onionsat-pcbs/neptune-env/bom.xlsx

Reference | Qty | Name/value | Footprint
C1 | 1 | 100nF | Capacitor_SMD:C_0603_1608Metric
C2,C4,C16,C17,C18,C19,C20,C21 | 8 | 100nF | Capacitor_SMD:C_0402_1005Metric
C5,C6,C8,C9,C11,C12 | 6 | 100nF | Capacitor_SMD:C_0201_0603Metric
C7,C10,C13 | 3 | 10nF | Capacitor_SMD:C_0402_1005Metric
C14,C15 | 2 | 1uF | Capacitor_SMD:C_0603_1608Metric
C22 | 1 | 4.7uF | Capacitor_SMD:C_0603_1608Metric
J1 | 1 | 8 pin, 2mm ptich, SMD, right angle socket | -
J2 | 1 | Neptune 2x10 connector, 1 female, 1 male | -
J3 | 1 | Neptune 2x10 connector, 1 female, 1 male | -
R1 | 1 | 10k | Resistor_SMD:R_0402_1005Metric
R2,R3,R4 | 3 | 4k Ohm 0.1% | Resistor_SMD:R_1206_3216Metric
SW1 | 1 | reset | -
TH1,TH2,TH3 | 3 | PT1000 | -
U1 | 1 | STM32L432KCUx | -
U2,U3,U4 | 3 | MAX31865xTP | -
U5 | 1 | AP2112K-3.3 | -
U6,U7,U8 | 3 | BME690 | -
