onionsat-pcbs/neptune-env/neptune-env/3d/BME690.stp

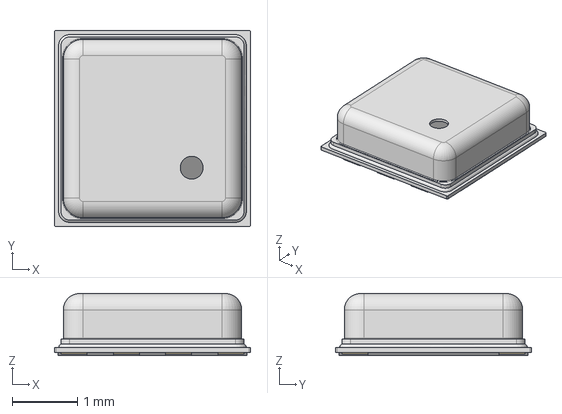
[picture p1: CAD file, 2025-12-16]
neptune-env/3d/BME690.stp
3.00 x 3.00 x 0.95 mm
