onionsat-pcbs/neptune-env/neptune-env/3d/ICM-20948.step

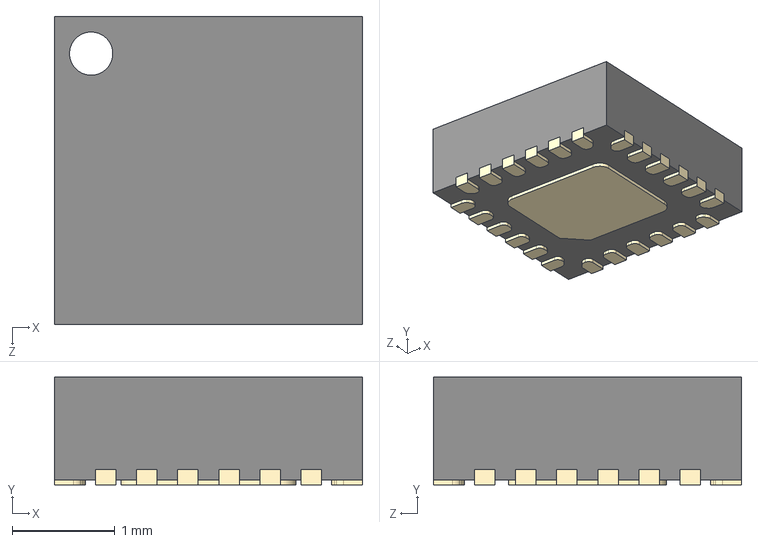
[picture p2: CAD file, 2025-12-16]
neptune-env/3d/ICM-20948.step
3.00 x 1.05 x 3.00 mm
