onionsat-pcbs/neptune-env/neptune-env/3d/KEY-SMD_L4.0-W3.0-LS4.9.step

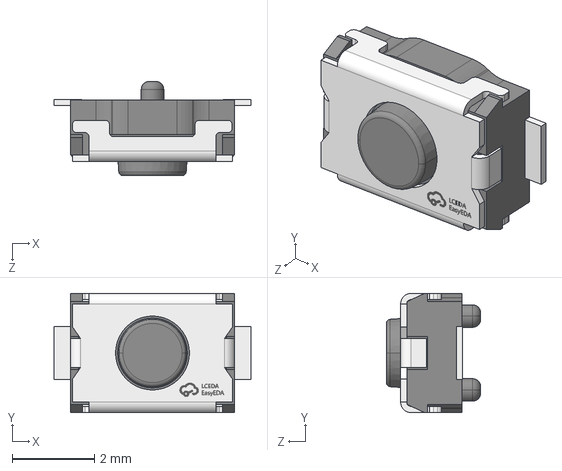
[picture p3: CAD file, 2025-12-11]
neptune-env/3d/KEY-SMD_L4.0-W3.0-LS4.9.step
4.80 x 2.90 x 2.30 mm
