onionsat-pcbs/neptune-env/neptune-env/3d/HDR2.00-F-LS-2X10P.step

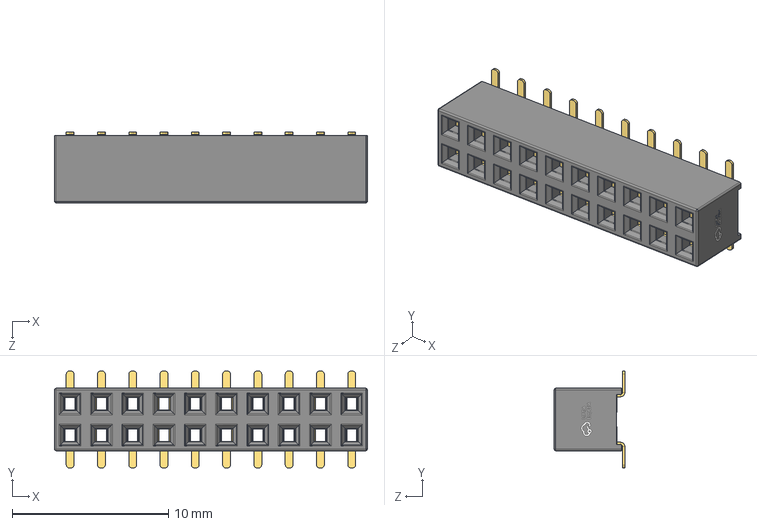
[picture p4: CAD file, 2025-12-11]
neptune-env/3d/HDR2.00-F-LS-2X10P.step
20.0 x 6.20 x 4.52 mm
