onionsat-pcbs/neptune-env/neptune-env/3d/HDR-SMD_8P-P2.00-H-F-W9.2.step

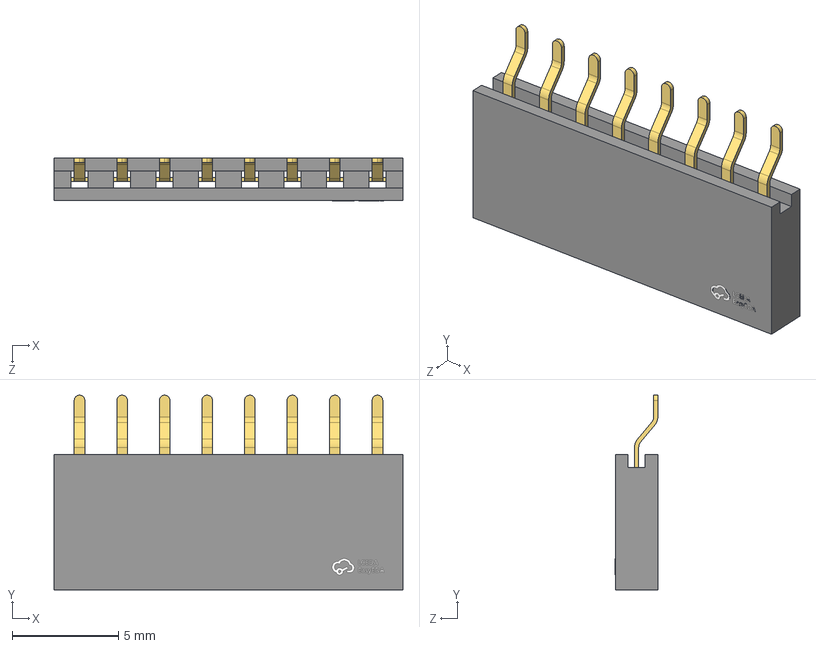
[picture p5: CAD file, 2025-12-09]
neptune-env/3d/HDR-SMD_8P-P2.00-H-F-W9.2.step
16.4 x 9.15 x 2.01 mm
