onionsat-pcbs/neptune-env/neptune-env/3d/max31865.step

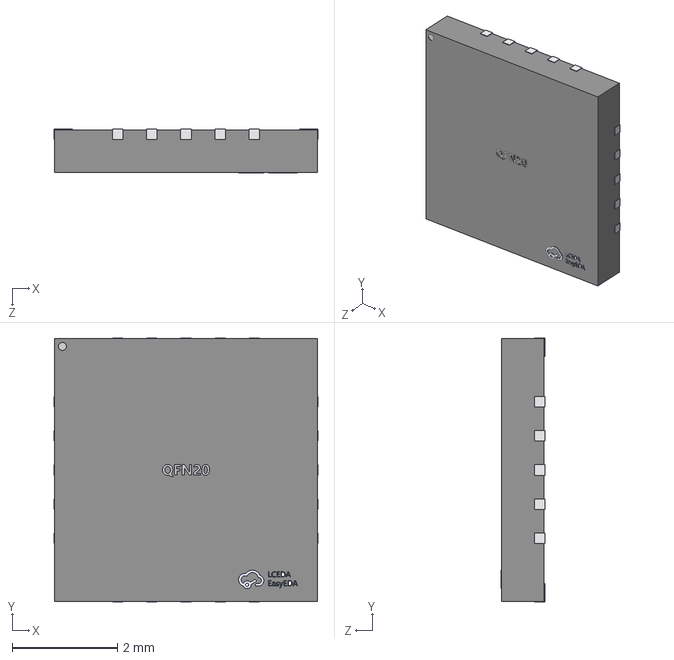
[picture p6: CAD file, 2025-12-11]
neptune-env/3d/max31865.step
5.02 x 5.02 x 0.83 mm
