onionsat-pcbs/neptune-env/neptune-env/neptune-env.kicad_pcb

## KiCad design neptune-env/neptune-env.kicad_pcb (2026-01-26)

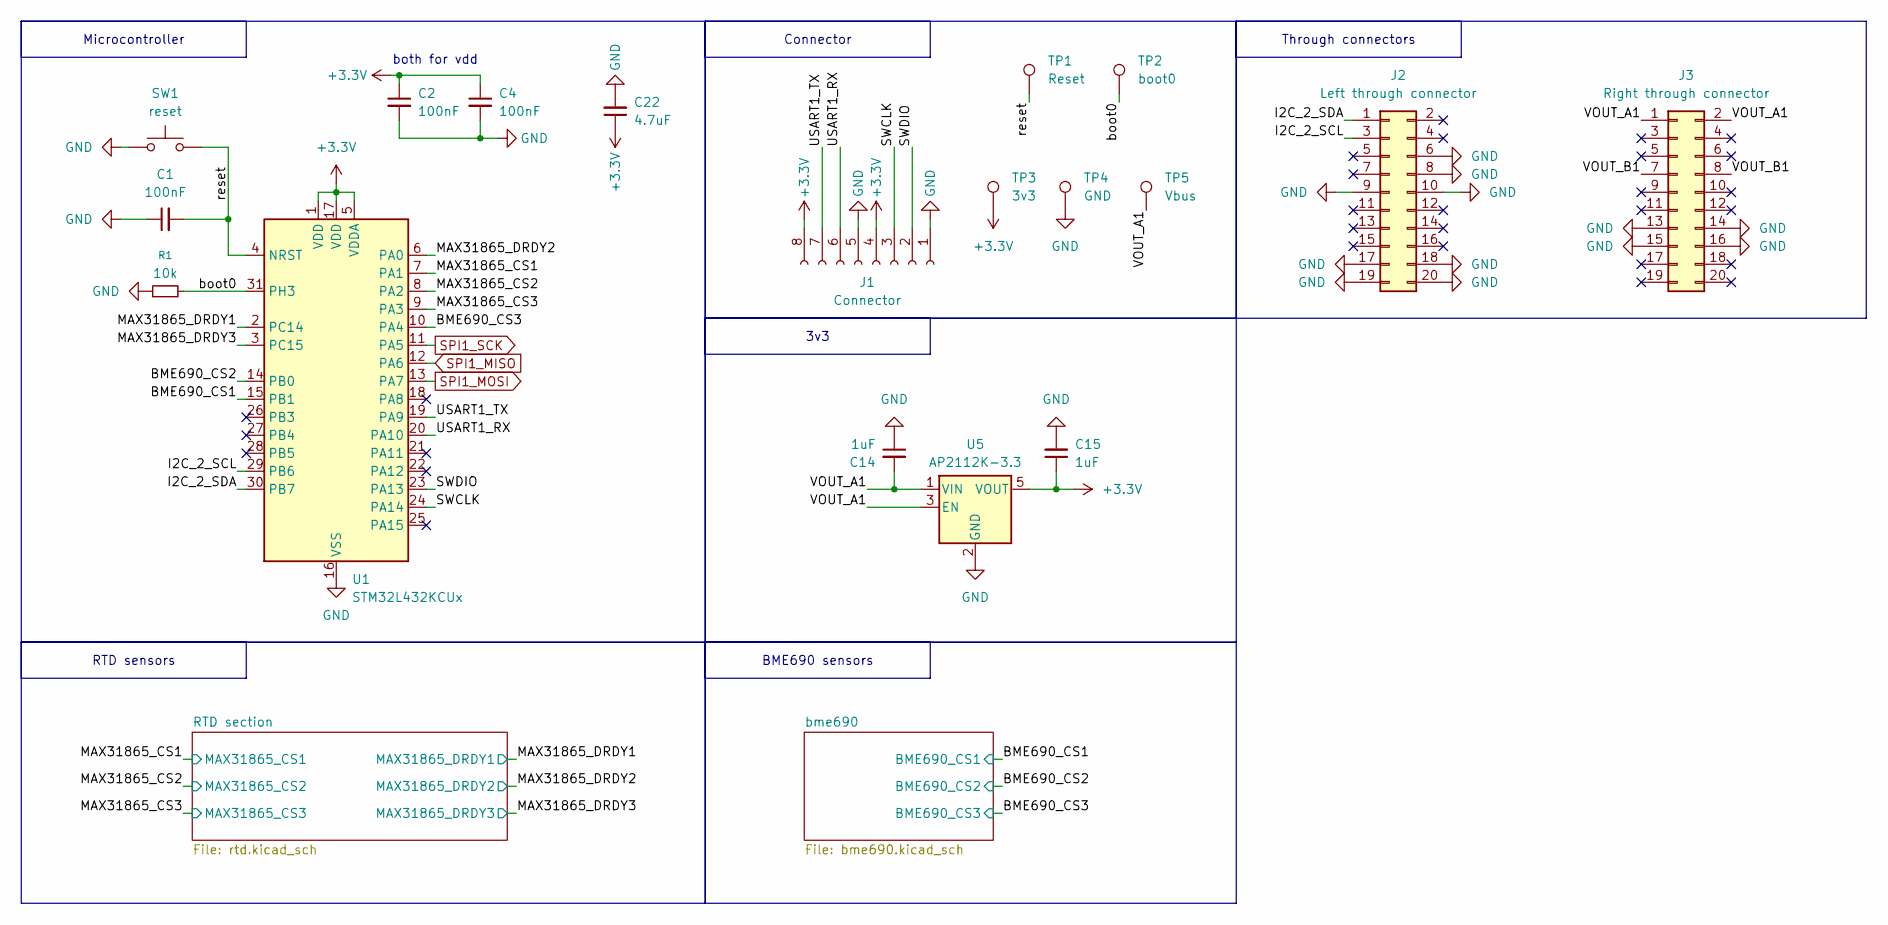
[picture p7: schematic neptune-env.kicad_sch, ENV PCB]

Parts:
C1: 100nF; C_0603_1608Metric
C2, C4: 100nF; C_0402_1005Metric
C14, C15: 1uF; C_0603_1608Metric
C22: 4.7uF; C_0603_1608Metric
J1: Connector; HDR-SMD_8P-P2.00-H-F-W9.2
J2: Left through connector; gaia_connector
J3: Right through connector; gaia_connector
R1: 10k; R_0402_1005Metric
SW1: reset; KEY-SMD_L4.0-W3.0-LS4.9-1
TP1: Reset; TestPoint_Pad_1.0x1.0mm
TP2: boot0; TestPoint_Pad_1.0x1.0mm
TP3: 3v3; TestPoint_Pad_1.5x1.5mm
TP4: GND; TestPoint_Pad_1.5x1.5mm
TP5: Vbus; TestPoint_Pad_1.5x1.5mm
U1: STM32L432KCUx
U5: AP2112K-3.3; ap2112

Connections:
+3.3V: C2.1, C4.1, C15.1, C22.1, J1.4, J1.8, TP3.1, U1.1 (VDD), U1.5 (VDDA), U1.17 (VDD), U5.5 (VOUT); also elsewhere on the board
/BME690_CS1: U1.15 (PB1); also elsewhere on the board
/BME690_CS2: U1.14 (PB0); also elsewhere on the board
/BME690_CS3: U1.10 (PA4); also elsewhere on the board
/I2C_2_SCL: J2.3, U1.29 (PB6)
/I2C_2_SDA: J2.1, U1.30 (PB7)
/MAX31865_CS1: U1.7 (PA1); also elsewhere on the board
/MAX31865_CS2: U1.8 (PA2); also elsewhere on the board
/MAX31865_CS3: U1.9 (PA3); also elsewhere on the board
/MAX31865_DRDY1: U1.2 (PC14); also elsewhere on the board
/MAX31865_DRDY2: U1.6 (PA0); also elsewhere on the board
/MAX31865_DRDY3: U1.3 (PC15); also elsewhere on the board
/SWCLK: J1.3, U1.24 (PA14)
/SWDIO: J1.2, U1.23 (PA13)
/USART1_RX: J1.6, U1.20 (PA10)
/USART1_TX: J1.7, U1.19 (PA9)
/VOUT_A1: C14.2, J3.1, J3.2, TP5.1, U5.1 (VIN), U5.3 (EN)
/VOUT_B1: J3.7, J3.8
/boot0: R1.2, TP2.1, U1.31 (PH3)
/reset: C1.2, SW1.2, TP1.1, U1.4 (NRST)
GND: C1.1, C2.2, C4.2, C14.1, C15.2, C22.2, J1.1, J1.5, J2.6, J2.8, J2.9, J2.10, J2.17, J2.18, J2.19, J2.20, J3.13, J3.14, J3.15, J3.16, R1.1, SW1.1, TP4.1, U1.16 (VSS), U1.32 (VSS), U1.33 (VSS), U5.2 (GND); also elsewhere on the board
SPI1_MISO: U1.12 (PA6); also elsewhere on the board
SPI1_MOSI: U1.13 (PA7); also elsewhere on the board
SPI1_SCK: U1.11 (PA5); also elsewhere on the board

Notes on the sheet:
both for vdd
Connector
Through connectors
Microcontroller
BME690 sensors
RTD sensors
3v3

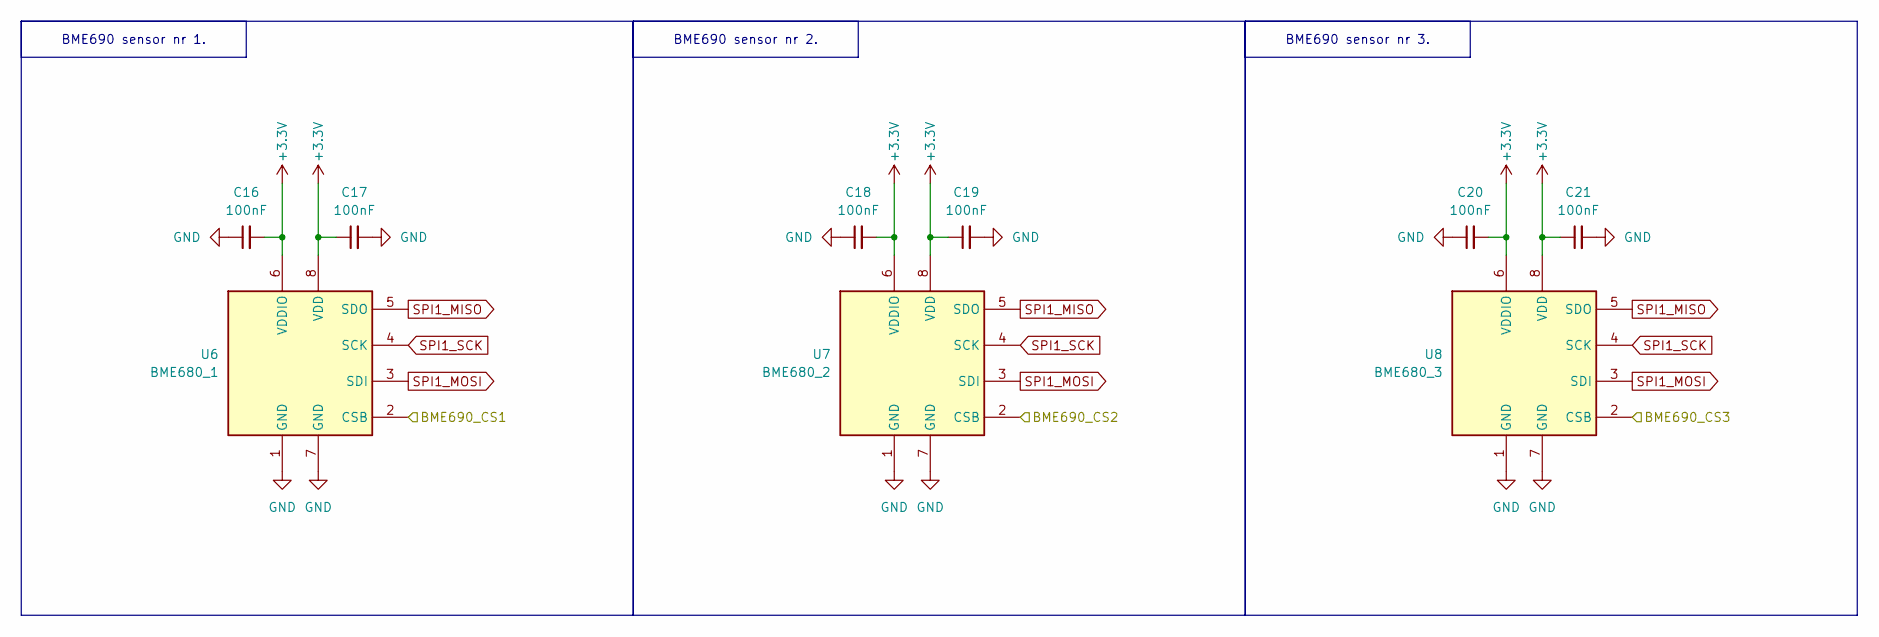
[picture p8: schematic bme690.kicad_sch, 3 BME690]

Parts:
C16, C17, C18, C19, C20, C21: 100nF; C_0402_1005Metric
U6: BME680_1; Bosch_LGA-8_3x3mm_P0.8mm_ClockwisePinNumbering
U7: BME680_2; Bosch_LGA-8_3x3mm_P0.8mm_ClockwisePinNumbering
U8: BME680_3; Bosch_LGA-8_3x3mm_P0.8mm_ClockwisePinNumbering

Connections:
+3.3V: C16.2, C17.1, C18.2, C19.1, C20.2, C21.1, U6.6 (VDDIO), U6.8 (VDD), U7.6 (VDDIO), U7.8 (VDD), U8.6 (VDDIO), U8.8 (VDD); also elsewhere on the board
/BME690_CS1: U6.2 (CSB); also elsewhere on the board
/BME690_CS2: U7.2 (CSB); also elsewhere on the board
/BME690_CS3: U8.2 (CSB); also elsewhere on the board
GND: C16.1, C17.2, C18.1, C19.2, C20.1, C21.2, U6.1 (GND), U6.7 (GND), U7.1 (GND), U7.7 (GND), U8.1 (GND), U8.7 (GND); also elsewhere on the board
SPI1_MISO: U6.5 (SDO), U7.5 (SDO), U8.5 (SDO); also elsewhere on the board
SPI1_MOSI: U6.3 (SDI), U7.3 (SDI), U8.3 (SDI); also elsewhere on the board
SPI1_SCK: U6.4 (SCK), U7.4 (SCK), U8.4 (SCK); also elsewhere on the board

Notes on the sheet:
BME690 sensor nr 3.
BME690 sensor nr 1.
BME690 sensor nr 2.

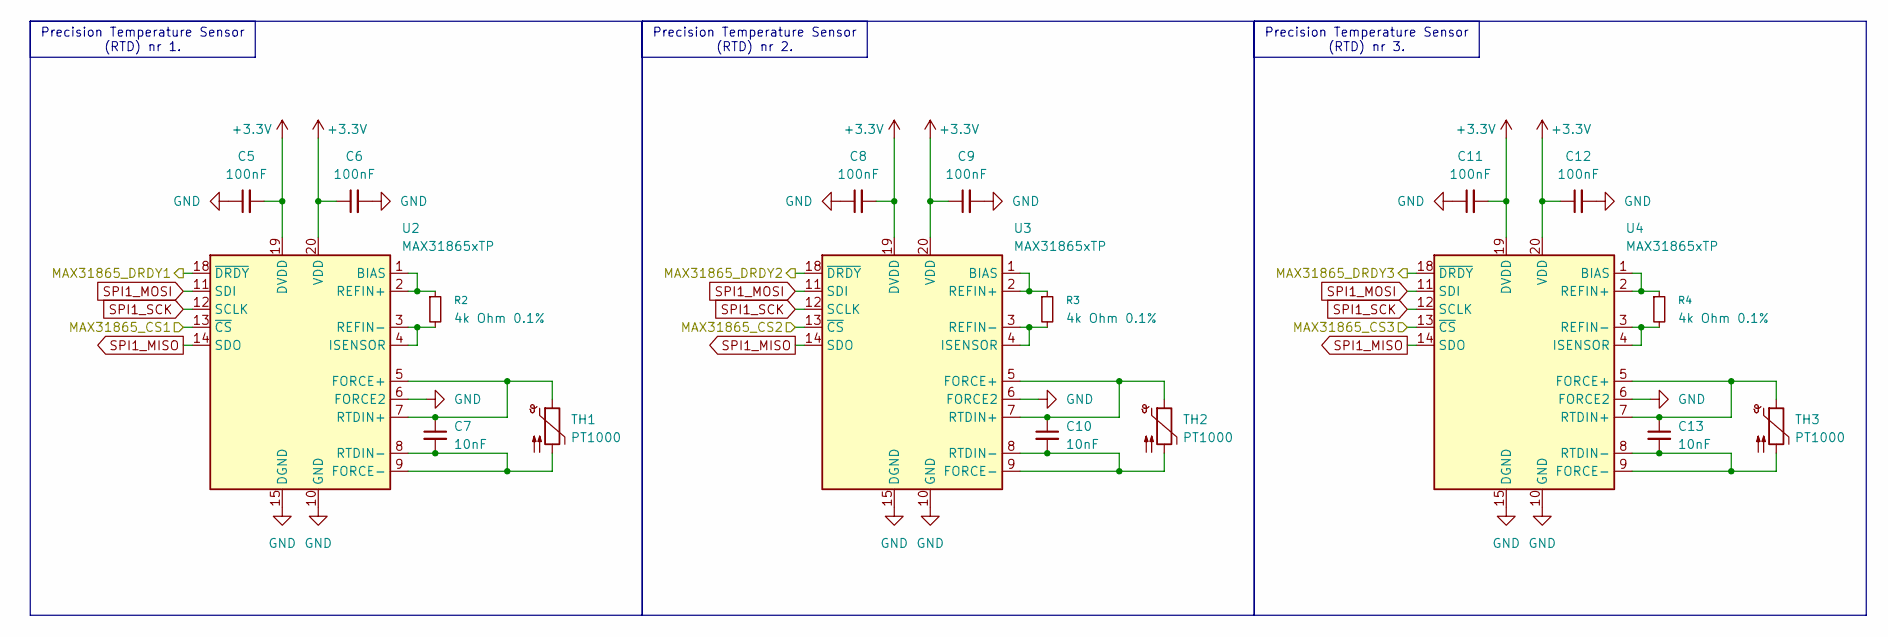
[picture p9: schematic rtd.kicad_sch, 3 RTD sensor]

Parts:
C5, C6, C8, C9, C11, C12: 100nF; C_0201_0603Metric
C7, C10, C13: 10nF; C_0402_1005Metric
R2, R3, R4: 4k Ohm 0.1%; R_1206_3216Metric
TH1, TH2, TH3: PT1000; yageo_m1020
U2, U3, U4: MAX31865xTP; MAX31865

Connections:
+3.3V: C5.2, C6.1, C8.2, C9.1, C11.2, C12.1, U2.19 (DVDD), U2.20 (VDD), U3.19 (DVDD), U3.20 (VDD), U4.19 (DVDD), U4.20 (VDD); also elsewhere on the board
/MAX31865_CS1: U2.13 (~CS); also elsewhere on the board
/MAX31865_CS2: U3.13 (~CS); also elsewhere on the board
/MAX31865_CS3: U4.13 (~CS); also elsewhere on the board
/MAX31865_DRDY1: U2.18 (~DRDY); also elsewhere on the board
/MAX31865_DRDY2: U3.18 (~DRDY); also elsewhere on the board
/MAX31865_DRDY3: U4.18 (~DRDY); also elsewhere on the board
GND: C5.1, C6.2, C8.1, C9.2, C11.1, C12.2, U2.6 (FORCE2), U2.10 (GND), U2.15 (DGND), U2.16 (GND), U2.21 (GND), U3.6 (FORCE2), U3.10 (GND), U3.15 (DGND), U3.16 (GND), U3.21 (GND), U4.6 (FORCE2), U4.10 (GND), U4.15 (DGND), U4.16 (GND), U4.21 (GND); also elsewhere on the board
unnamed: R2.1, U2.1 (BIAS), U2.2 (REFIN+)
unnamed: C7.1, TH1.1, U2.5 (FORCE+), U2.7 (RTDIN+)
unnamed: C7.2, TH1.2, U2.8 (RTDIN-), U2.9 (FORCE-)
unnamed: R2.2, U2.3 (REFIN-), U2.4 (ISENSOR)
unnamed: R3.1, U3.1 (BIAS), U3.2 (REFIN+)
unnamed: C10.1, TH2.1, U3.5 (FORCE+), U3.7 (RTDIN+)
unnamed: C10.2, TH2.2, U3.8 (RTDIN-), U3.9 (FORCE-)
unnamed: R3.2, U3.3 (REFIN-), U3.4 (ISENSOR)
unnamed: R4.1, U4.1 (BIAS), U4.2 (REFIN+)
unnamed: C13.1, TH3.1, U4.5 (FORCE+), U4.7 (RTDIN+)
unnamed: C13.2, TH3.2, U4.8 (RTDIN-), U4.9 (FORCE-)
unnamed: R4.2, U4.3 (REFIN-), U4.4 (ISENSOR)
SPI1_MISO: U2.14 (SDO), U3.14 (SDO), U4.14 (SDO); also elsewhere on the board
SPI1_MOSI: U2.11 (SDI), U3.11 (SDI), U4.11 (SDI); also elsewhere on the board
SPI1_SCK: U2.12 (SCLK), U3.12 (SCLK), U4.12 (SCLK); also elsewhere on the board

Notes on the sheet:
Precision Temperature Sensor (RTD) nr 3.
Precision Temperature Sensor (RTD) nr 2.
Precision Temperature Sensor (RTD) nr 1.

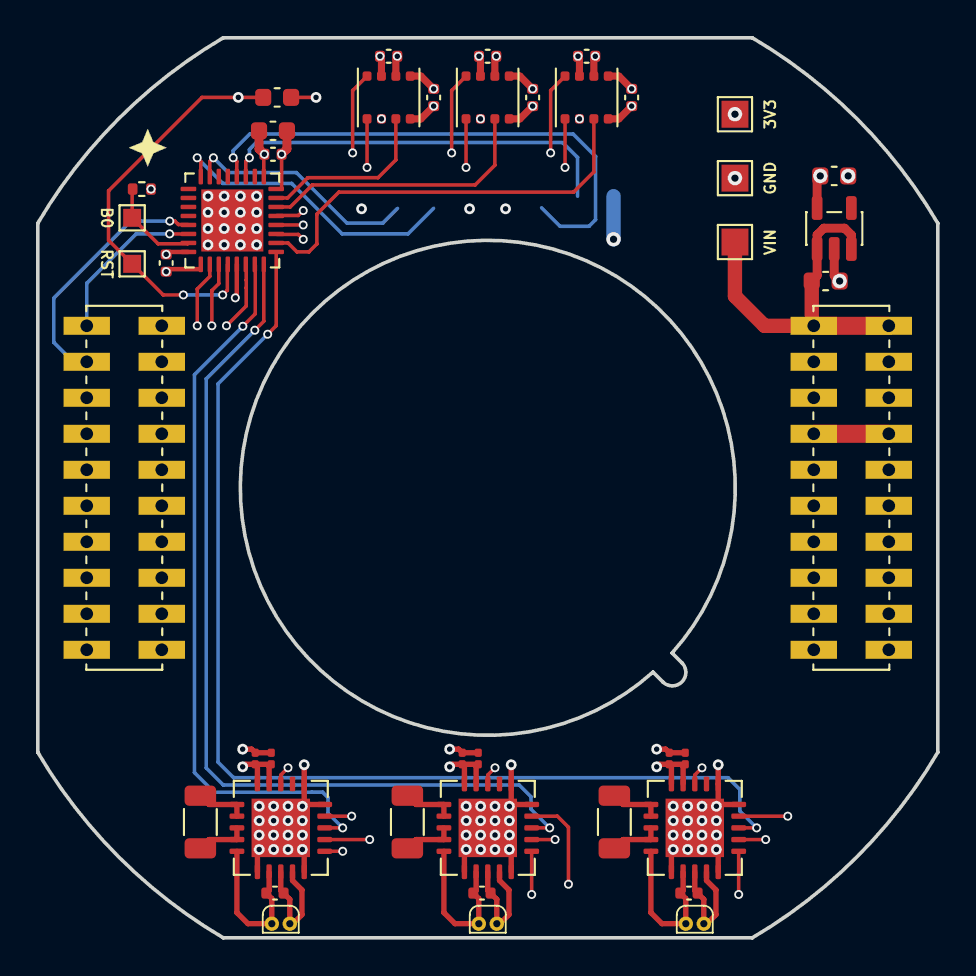
[picture p10: board neptune-env.kicad_pcb from above]

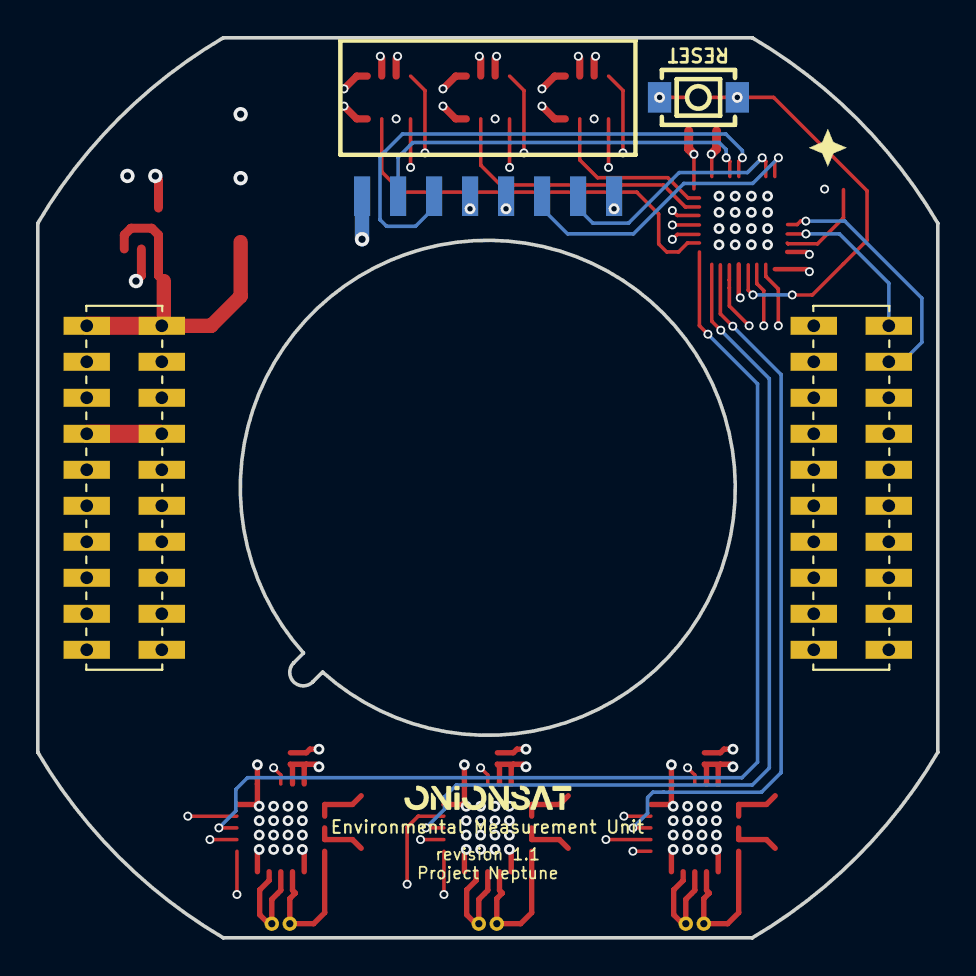
[picture p11: board neptune-env.kicad_pcb from below]

Board: 6 copper layers, 50.0 x 50.0 mm, 45 parts (2 on the bottom side), 36 nets.
