onionsat-pcbs/neptune-env/(commit log)

2025-12-08 initial relase
    [neptune-imu.kicad_pcb, neptune-imu.kicad_sch]
2025-12-09 no summary
    [HDR-SMD_8P-P2.00-H-F-W9.2.step, bme690.kicad_sch, neptune-imu.kicad_pcb, neptune-imu.kicad_sch, rtd.kicad_sch]
2025-12-11 almost ready
    [HDR2.00-F-LS-2X10P.step, KEY-SMD_L4.0-W3.0-LS4.9.step, LGA-8_L3.0-W3.0-P0.80-TR-1.step, max31865.step, neptune-imu.kicad_pcb, neptune-imu.kicad_sch, rtd.kicad_sch]
2025-12-11 project naming updated
    [HDR-SMD_8P-P2.00-H-F-W9.2.step, HDR2.00-F-LS-2X10P.step, KEY-SMD_L4.0-W3.0-LS4.9.step, LGA-8_L3.0-W3.0-P0.80-TR-1.step, bme690.kicad_sch, max31865.step, neptune-env.kicad_pcb, neptune-env.kicad_sch]
2025-12-11 some advancements
    [neptune-env.kicad_pcb]
2025-12-16 some final things to do
    [BME690.stp, HDR2.00-F-LS-2X10P.step, ICM-20948.step, LGA-8_L3.0-W3.0-P0.80-TR-1.step, bom.xlsx, neptune-env.kicad_pcb, neptune-env.kicad_sch]
2025-12-16 ready
    final check needed
    [neptune-env.kicad_pcb]
2025-12-17 working on my PC
    [neptune-env.kicad_pcb]
2025-12-18 Review: OK for production
    [neptune-env.kicad_pcb]
2025-12-21 fixing bugs, production
    [neptune-env-3V3.gbr, neptune-env-B_Cu.gbr, neptune-env-B_Mask.gbr, neptune-env-B_Paste.gbr, neptune-env-B_Silkscreen.gbr, neptune-env-Edge_Cuts.gbr, neptune-env-F_Cu.gbr, neptune-env-F_Mask.gbr]
2026-01-07 3D modell fixek
    [HDR2.00-F-LS-2X10P.step, neptune-env.kicad_pcb]
2026-01-26 v1.1 - PRODUCTION
    Header FIX
    [neptune-env-3V3.gbr, neptune-env-B_Cu.gbr, neptune-env-B_Mask.gbr, neptune-env-B_Paste.gbr, neptune-env-B_Silkscreen.gbr, neptune-env-Edge_Cuts.gbr, neptune-env-F_Cu.gbr, neptune-env-F_Mask.gbr]
